nynauk/optical-fibre-link/hardware/schematics/receiver_tia_2026-03-11.png

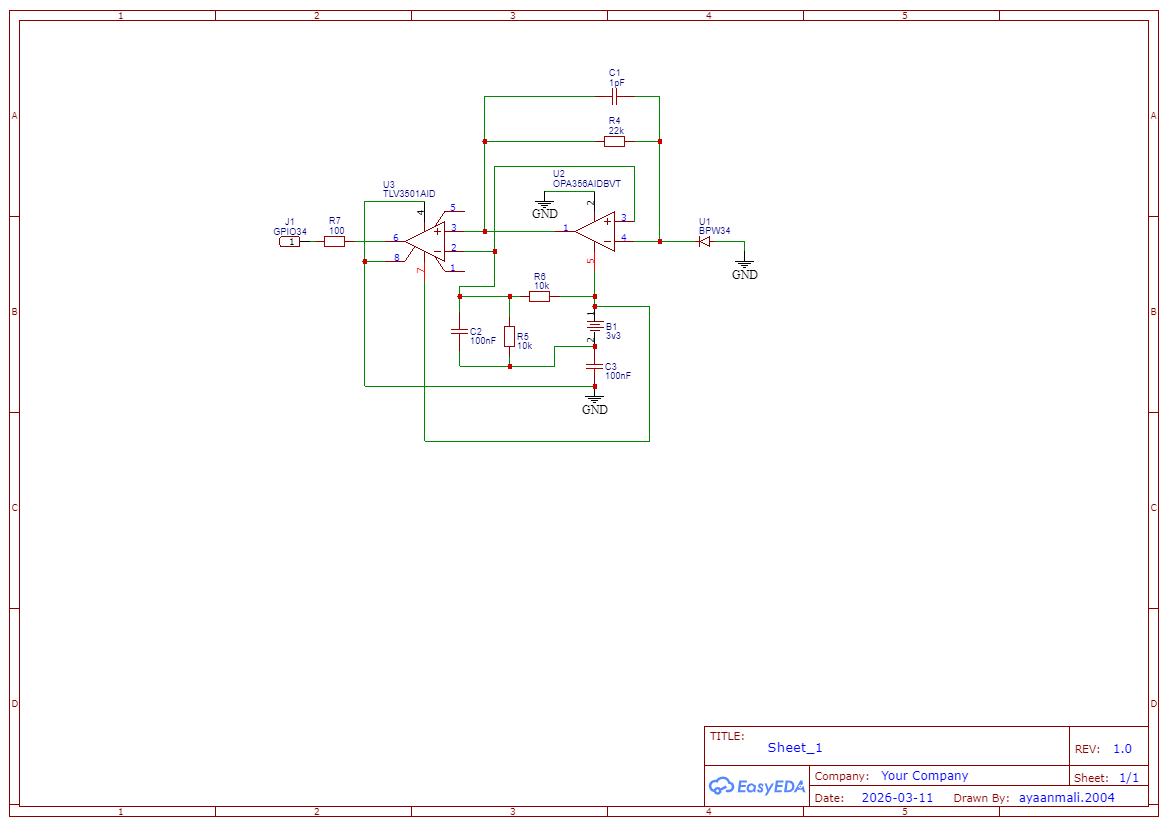
hardware/schematics/receiver_tia_2026-03-11.png
