nynauk/optical-fibre-link/hardware/schematics/system_schematic_2026-02-14.png

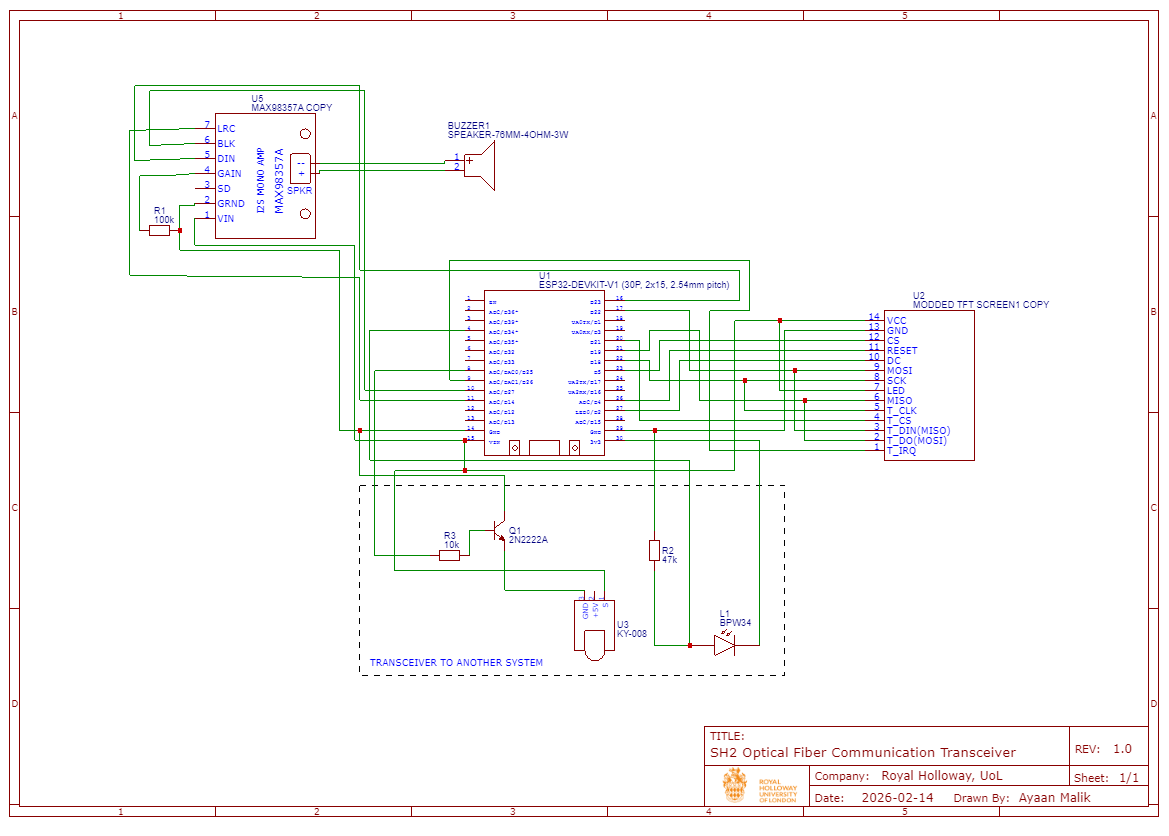
hardware/schematics/system_schematic_2026-02-14.png
