nynauk/optical-fibre-link/hardware/3d-printed/laser_adapter_v3.step

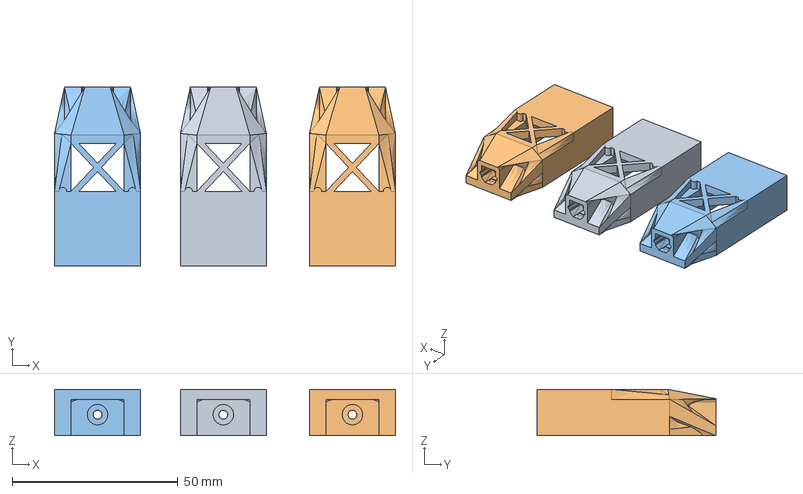
[picture p4: CAD file, 2026-11-07]
hardware/3d-printed/laser_adapter_v3.step
103.0 x 54.0 x 14.0 mm
