nynauk/optical-fibre-link/hardware/3d-printed/final_adapter.stl

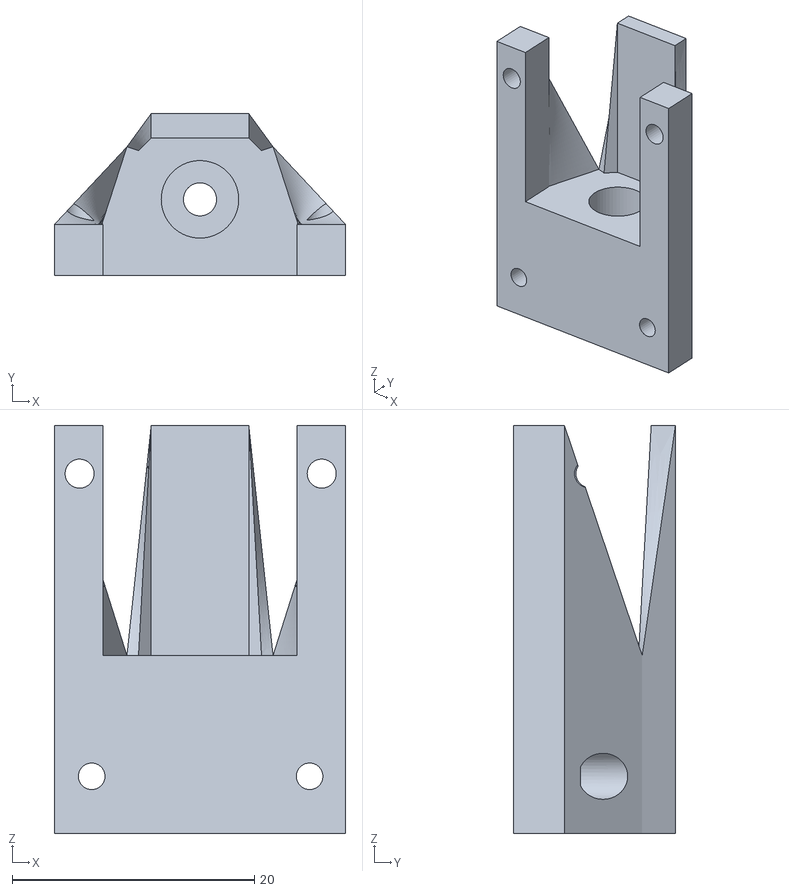
[picture p5: CAD file, 2026-11-07]
hardware/3d-printed/final_adapter.stl
24.1 x 13.4 x 33.7
