nynauk/optical-fibre-link/hardware/3d-printed/bpw34_adapter_final.stl

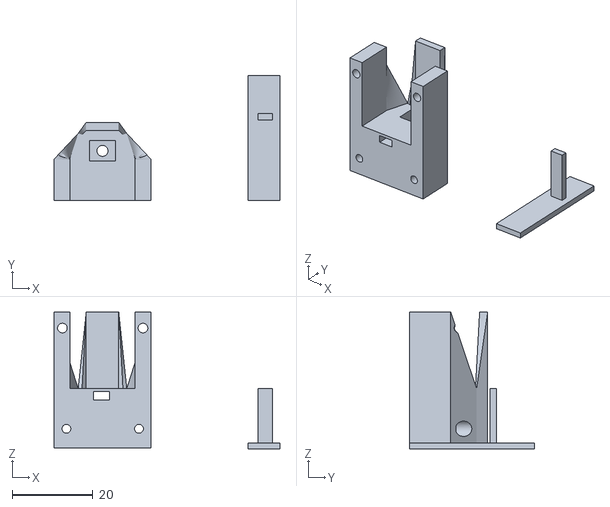
[picture p6: CAD file, 2026-11-07]
hardware/3d-printed/bpw34_adapter_final.stl
56.1 x 31.0 x 34.0
