nynauk/optical-fibre-link/hardware/earlier-boards/board-revisions.png

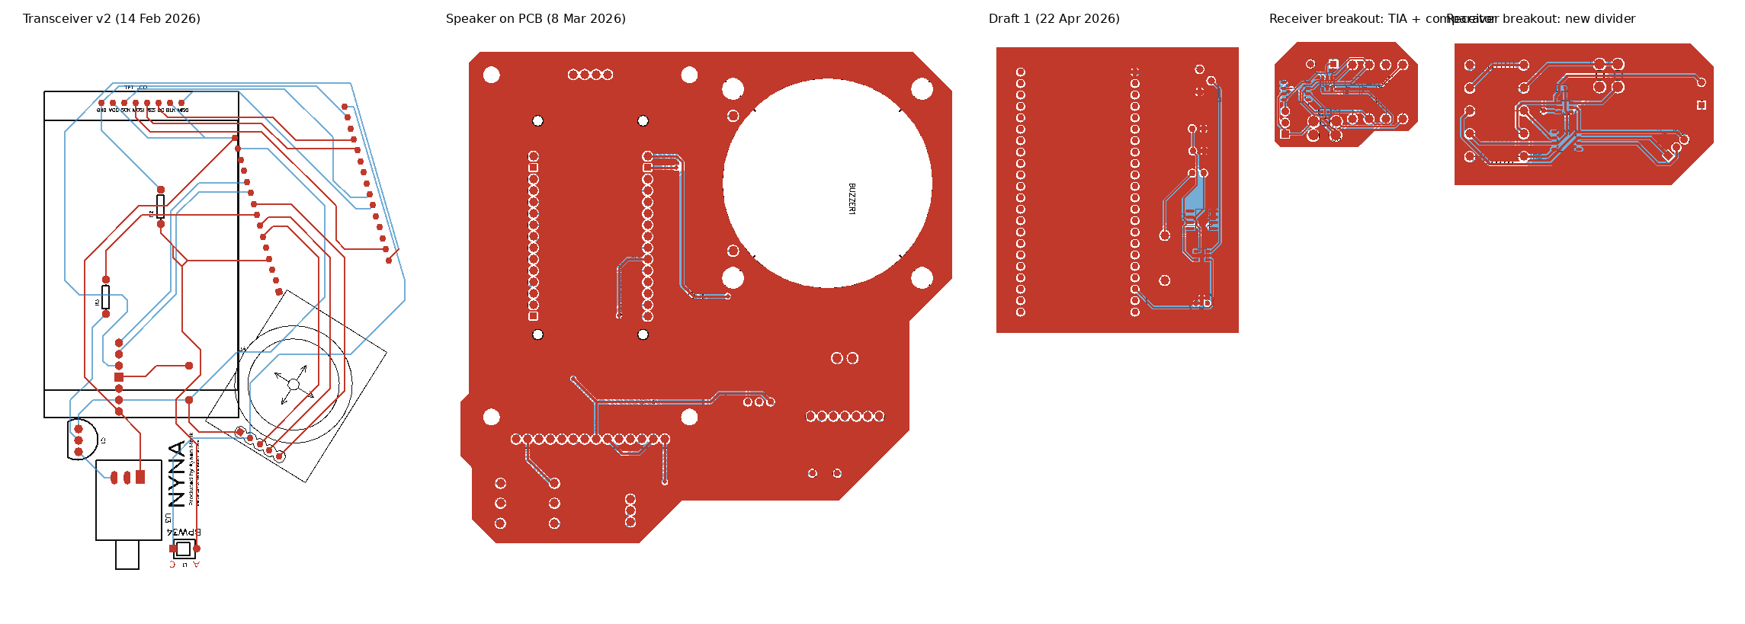
hardware/earlier-boards/board-revisions.png
