nynauk/optical-fibre-link/(commit log)

2026-11-07 Initial commit: code, results and write-up
    [Drill_NPTH_Through.DRL, Drill_PTH_Through.DRL, Drill_PTH_Through_Via.DRL, Gerber_BoardOutlineLayer.GKO, Gerber_BottomLayer.GBL, Gerber_BottomSolderMaskLayer.GBS, Gerber_TopLayer.GTL, Gerber_TopPasteMaskLayer.GTP]
2026-11-07 Add the February and March schematics, the 3D-printed fibre adapters, an early transmitter sketch and the audio-over-laser firmware variant
    [bpw34_adapter_final.stl, final_adapter.stl, laser_adapter_v3.step]
2026-11-07 Add the earlier board layouts and renders of the final and earlier boards
    [Drill_NPTH_Through.DRL, Drill_PTH_Through.DRL, Drill_PTH_Through_Via.DRL, Gerber_BoardOutlineLayer.GKO, Gerber_BottomLayer.GBL, Gerber_BottomSilkscreenLayer.GBO, Gerber_BottomSolderMaskLayer.GBS, Gerber_TopLayer.GTL]
